xiesiqi1/git-test/README.md

# STM32F103 五路循迹小车

面向 **2026 全国大学生电子设计竞赛 H 题《车载平衡滚球运动控制系统》** 的循迹底盘。
目标是在 H 题赛道上完成 **"从 A 点出发 → 跑满一整圈 → 自动停在 A 点"**，并预留声光提示与里程接口给后续的滚球控制部分。

赛道与指标（H 题）：

| 项目 | 数值 |
|---|---|
| 赛道构成 | 2 × 1.5 m 直线 + 2 × R 0.5 m 半圆（黑线宽 1.8 cm） |
| 一圈周长 | 6.142 m |
| 限时 | ≤ 20 s（平均 ≥ 0.31 m/s） |
| 停车偏差 | ≤ 2 cm |

当前实测：**一圈 25.5 s**，自动停车由**里程**判定（`LAP DONE`），压线判定作为并行入口保留。

功能一览：

- 五路红外循迹，开环 PWM + 比例 + **虚拟前视**（用 `LEAD_TICKS` 把探头"电气前移"，等效约 3.9 cm）
- 弯道按差速**成比例收油**，并带**独立上限**（避免收油被积分项叠加到地板）
- **自动停车双入口**：压停止线 / 里程跑满一圈，二者共用同一个断油函数
- 1.3" OLED 实时显示误差、差速、左右 PWM、探头状态、编码器里程（本工程无串口，屏是唯一调试窗口）
- 跑圈计时（本圈 / 上圈）、A/B 点声光提示、掉速档案（`BMIN` / `LMAX` / `SLOW@`）
- 传感器极性 / 转向极性可在**不重新编译**的情况下用按键标定，结果存 Flash

---

## 一、硬件清单

| 部件 | 型号 / 规格 | 数量 | 与本工程的连接 |
|---|---|---|---|
| 主控 MCU | **STM32F103C8T6**（LQFP48，Cortex-M3，72 MHz，64 KB Flash / 20 KB RAM） | 1 | HSE 8 MHz 晶振 × PLL9 = 72 MHz |
| 电机驱动 | **L298N** 双 H 桥模块（VMS 7~12 V，ENA/ENB 接 1 kHz PWM） | 1 | 见下方引脚表 |
| 驱动电机 | 双直流减速电机，尾部带 **AB 相增量编码器** ⚠ 具体型号 / 减速比 / 轮径未记录 | 2 | TIM2（左）、TIM4（右）编码器接口 |
| 循迹传感器 | **5 路红外反射式数字量模块**（TCRT5000 类，带比较器与灵敏度电位器） ⚠ 具体型号未记录 | 1 | PA3 ~ PA7，MCU 内部上拉 |
| 显示屏 | **1.3 英寸 OLED，128×64，SH1106 驱动，SPI 4 线**（⚠ 不是 SSD1306：1.2 寸及以下才是） | 1 | SPI2 + 3 根控制线 |
| 蜂鸣器 | 3 脚**有源**蜂鸣器模块（VCC / GND / IO），**高电平响**（已实测） | 1 | PB0 |
| 指示灯 | 板载 LED，**低电平亮** | 1 | PC13 |
| 按键 | 轻触按键（内部上拉，按下接地） | 1 | PA15 |
| 下载器 | ST-Link V2（**SWD**，PA13 = SWDIO / PA14 = SWCLK） | 1 | — |
| 电源 | L298N VMS 接 7~12 V；逻辑侧由 USB / ST-Link 3.3 V 供电。**两侧必须共地** | — | — |

> ⚠ 标记项是本工程没有留下实测记录的参数。它们**不影响使用**：里程已按"一圈的实测脉冲数"标定，与轮径、编码器分辨率、减速比全部解耦。
> 若要补齐，只需在更换轮子 / 电机 / 编码器时重跑一次标定（见第四节第 6 步）。

机械安装要点：

- 五路探头前沿距车轴 **≥ 3 cm**（< 2 cm 必丢线），探头离地 **8 ~ 15 mm**。
- 轮距 **0.27 m**（实测值，已用于仿真模型）。

### 引脚分配

| 功能 | 引脚 | 说明 |
|---|---|---|
| 右电机 IN1 / IN2 | PA11 / PA12 | 方向 |
| 左电机 IN3 / IN4 | PA9 / PB3 | 方向（PB3 由 `SWJ_NOJTAG` 从 JTDO 释放） |
| 右 / 左 PWM | PB4 / PB5 | TIM3_CH1 / CH2，1 kHz |
| 左编码器 A / B | PA0 / PA1 | TIM2 编码器模式（TI1，单边沿计数） |
| 右编码器 A / B | PB6 / PB7 | TIM4 编码器模式（TI1） |
| 五路循迹 | PA3 ~ PA7 | 从左到右，输入上拉 |
| 按键 | PA15 | 单击 / 双击 / 三击 / 长按 |
| 蜂鸣器 | PB0 | 高电平响 |
| 板载 LED | PC13 | 低电平亮 |
| OLED | PB13 SCK / PB15 MOSI / PB12 CS / PB14 DC / PA8 RES | SPI2 只发主模式 |
| 下载 / 调试 | PA13 / PA14 | **SWD，不能用 JTAG** |
| 晶振 | PD0 / PD1 | ★ HSE 8 MHz，**绝不能当 GPIO** |

## 二、软件环境

| 项目 | 版本 | 说明 |
|---|---|---|
| Keil MDK-ARM | **V5.43**（UV4 5.43.1.0） | 打开 `MDK-ARM/Test1.uvprojx` |
| 编译器 | **ARMCC V5.06 update 20（AC5）** | 工程 `uAC6 = 0`，不是 AC6/Clang |
| 器件包 | **Keil.STM32F1xx_DFP 1.1.0** | Device = STM32F103C8 |
| STM32CubeMX | **6.15.0** | 工程文件 `TEST1.ioc` |
| STM32Cube 固件包 | **STM32Cube FW_F1 V1.8.7** | HAL 库 |
| 图形库 | u8g2（裁剪版） | `Middlewares/u8g2/`，仅 SH1106 + 6x10 / 5x7 字库 |
| Python 3（可选） | 3.x，**仅标准库**（math / random） | `tools/` 下的赛道仿真脚本 |

当前占用：**Flash 17.2 KB / 64 KB，RAM 2.7 KB / 20 KB**。

目录结构：

```
TEST1/
├─ Core/            CubeMX 生成的 HAL 初始化与 main.c（CtrlLoop 在 SysTick 中断里，5 ms 一拍）
├─ safe/            手写应用层：track / motor / encoder / key / oled / mileage / stopwatch / signal
├─ Middlewares/     u8g2 图形库
├─ MDK-ARM/         Keil 工程（Test1.uvprojx）
├─ tools/           赛道仿真：sim_H_track.py（主模型）/ sim_corner_slow.py / sim_turn_unify.py
├─ TEST1.ioc        CubeMX 工程
└─ car.txt          ★ 接线表 + 调参手册（19 节，故障排查全部在这里）
```

## 三、快速启动

### 0) 获取代码

```bash
git clone git@github.com:xiesiqi1/git-test.git
cd git-test
```

仓库地址：<https://github.com/xiesiqi1/git-test>

> 仓库里**不含编译产物**（`MDK-ARM/Test1/` 整个输出目录已在 `.gitignore` 中忽略），
> `Test1.hex` 需要按下一步自行编译生成。这样每次提交只反映真实的代码改动，
> 不会混入几十个 `.o` / `.axf`。

### 1) 接线

按 `car.txt` 第一 ~ 五节接线。**最容易漏的一条：L298N 的 GND 必须与 STM32 的 GND 相连**，否则电机乱转或不动。

### 2) 编译

Keil 图形界面：打开 `MDK-ARM/Test1.uvprojx` → `Rebuild`（全量）→ 必须 **0 Error / 0 Warning**。

命令行（等价，便于脚本化）：

```bash
cd MDK-ARM
"C:/Keil_v5/UV4/UV4.exe" -r Test1.uvprojx -j0 -o build_log.txt
```

> `-r` 全量重建，`-b` 增量编译。**"0 Error / 0 Warning"是硬规矩**：本项目曾因注释少一个 `*/` 把下一行宏定义吞掉，编译器只给一条警告、不报错。

### 3) 下载

ST-Link + SWD 下载。`Options for Target → Debug → Settings → Flash Download` 里擦除方式选 **Erase Sectors**：

> ⚠ **不要用 Erase Full Chip**。传感器极性 / 转向极性标定值存在 Flash 尾部，全片擦除会退回默认值 —— 那会让车"突然朝赛道对角直冲"。

### 4) 上电自检

上电后 OLED 应显示自检画面，**蜂鸣器应安静**（一直响说明电平方向反了，改 `BUZZER_ACTIVE_LEVEL`）。
把两个轮子**架空**，长按 PA15 超过 0.8 s：左轮前进 1 s → 停 → 右轮前进 1 s → 停。用来确认电机接线、左右是否搞反。

### 5) 跑一圈

在起步位置的车轮下做个记号 → 短按 PA15 启动 → 车自动循迹一整圈 → 里程到 6.142 m 时**立即断油停车**，屏上第 1 行显示：

```
LAP DONE  T 25.5      ← 里程判定停车（T = 本圈成绩）
HIT LINE  T 25.5      ← 压停止线判定停车
```

两个标签就是"是哪个入口停的"的唯一线索。

### 6) 对准停车点（目标 ≤ 2 cm）

量车轮标记相对起步标记差了几厘米：

- 冲过头 → `STOP_MILEAGE_COUNT` **调小**
- 没到 → **调大**

标尺：**1 cm ≈ 2300 计数**（一圈 6.142 m = 1 400 000 计数）。
只改这一个数，**不要动 `MILEAGE_LAP_COUNT`** —— 它还管着 B 点提示的位置。

## 四、关键参数（`safe/config.h`）

| 宏 | 当前值 | 含义 |
|---|---|---|
| `CTRL_PERIOD_MS` | 5 | 控制周期（SysTick 中断） |
| `SIMPLE_BASE_SPEED` | 32 | 直道基础 PWM（提速只调这一个，一次 +4） |
| `SIMPLE_KP` | 14 | 比例增益 |
| `SIMPLE_LEAD_TICKS` | 30 | 虚拟前视拍数（等效探头前移 ≈ 3.9 cm） |
| `SIMPLE_CORNER_SLOW` | 50 | 弯道按差速成比例收油（%） |
| `SIMPLE_CORNER_SLOW_MAX` | 6 | ★ 收油**绝对上限**（不动差速，只压收油） |
| `SIMPLE_LOST_SPEED` | 20 | 丢线时的降速值 |
| `MILEAGE_LAP_COUNT` | 1400000 | 一圈的编码器平均计数（已标定） |
| `STOP_MILEAGE_ENABLE` / `STOP_MILEAGE_COUNT` | 1 / 1400000 | 里程停车入口 |
| `STOP_LINE_ENABLE` / `ARM_COUNT` | 1 / 1120000 | 压线停车入口 + 里程门槛（80%） |
| `STOP_LINE_MIN_ACTIVE` / `CONFIRM` | 4 / 6 | 连续 4 路 + 连续 6 拍 |
| `BUZZER_ACTIVE_LEVEL` / `LED_ACTIVE_LEVEL` | 1 / 0 | 蜂鸣器高电平响、LED 低电平亮（方向相反） |

调参方法与故障排查表见 `car.txt`：第十五节（OLED）、第十六节（自动停车）、第十七节（声光与里程）、第十八节（实车读数范例）、第十九节（掉速定因）。

## 五、屏幕读数

运行时（6 行 × 21 字符）：

```
RUN  T12.3 L11.8     本圈 / 上圈计时
E  -2    LOST 0      夹线误差(-4~+4, 99=丢线) / 连续丢线拍数
B  32    DIFF -12    本拍基础速度(含收油) / 本拍下发的差速
L  44    R  20       左右轮 PWM
[ ][X][X][ ][ ]      五路探头，实心 = 压到黑线
ENC 1582 1204 M2     左右累计计数(÷1000) + 已到哪个标记点
```

停车后第 2、3、4 行换内容（`B/DIFF/L/R` 停车后没有信息量）：

```
BMIN 26/26 LMAX 0    本圈最小 base（看见线 / 含丢线拍）+ 最长连续丢线拍数
EVT  4  MAXW 5       宽线事件次数 / 整圈最宽一拍压了几路
SLOW@ 141K WIDE@ 850K  最慢那一拍的位置 / 首次触发的位置（单位：千计数）
```

## 六、注意事项

1. **CubeMX 重新生成代码会覆盖 `Core/*`、清掉 `Middlewares/u8g2/`、并可能把 HSE 改回 `RCC_HSE_OFF`**（那样上电没反应）。每次 Generate 后必须检查 `.ioc` 里 PD0/PD1 仍是 OSC_IN/OSC_OUT，以及 `SystemClock_Config()` 里的 `HSEState`。
2. `CtrlLoop()` 跑在 **SysTick 中断**里，任何地方都不能死等（声光提示用状态机 + 自动重装，不用 `HAL_Delay`）。
3. 跑动中**不要抬车、不要用手挡探头**：五路全黑会被判成"压到宽线"，门槛满足时会当场停车。
4. 本工程**没有串口**（PA9/PA2/PA3 已被电机与探头占用），唯一调试窗口是 OLED。

## 七、当前状态与待办

- ✅ 循迹、计时、OLED、双入口自动停车、声光、里程标定、掉速档案
- ✅ 一圈 **25.5 s**（仿真 25.21 s，误差 1%）
- ⏳ 提速到 ≤ 20 s：`SIMPLE_BASE_SPEED` 32 → 36 → 40，每档回看 `BMIN`（掉到 19 = 收不够）与 `LMAX`（> 10 = 开始丢线）
- ⏳ `EVT` 改为边沿计数（现在一次穿越会记 4~7 次）
- ⏳ 补齐电机 / 编码器 / 轮径的型号记录
- ⏳ H 题第 4 / 6 项：钢球稳定在摆杆中心（尚未开始）
