xiesiqi1/git-test/safe/config.h

#ifndef __CONFIG_H
#define __CONFIG_H

/* ============================================================
 *                    循 迹 参 数 总 表
 * ============================================================
 * 赛道(2026 电赛 H 题): 2 段 1.5 m 直线 + 2 个半径 0.5 m 半圆,
 *   黑线宽 1.8 cm, 周长 = 2×1.5 + 2×π×0.5 ≈ 6.14 m
 *   要求一圈 <= 20 s  ->  平均速度必须 >= 0.31 m/s
 *   标定基准: 直线段 1.5 m 要在 4.8 s 内跑完(用秒表量)
 *
 * ★★★ 最重要的一条: 探头【必须装在驱动轮轴的前方】★★★★
 *   2026-09-25 仿真结论(已含偏航静摩擦, 用本文件当前参数重扫): 探头相对
 *   驱动轮轴的前后位置是悬崖式的临界 ——
 *        探头在轮轴后 1 cm  -> 出线(偏离 6.0 cm)
 *        探头正好在轮轴上  -> 出线(偏离 6.1 cm)
 *        探头前移 0.5 cm   -> 出线(偏离 6.0 cm)
 *        探头前移 1.0 cm   -> 会丢线(横偏 49 mm, 丢线 899 拍)
 *        探头前移 2.0 cm   -> 能跑(横偏 15.8 mm, 余量很小)
 *        探头前移 3.0 cm   -> 好(横偏 8.2 mm)
 *   为什么: 只有"提前看到"才能提前打舵。探头在轮轴上时, 等它发现偏了, 车
 *   已经冲出去了 —— 表现就是"进弯反应慢, 等跑出弯道才转弯, 然后找不到线"。
 *   ★ 实测方法: 量一下【两驱动轮中心连线】到【探头板中心】的前后距离。
 *     小于 2 cm 就别调参数了, 先把它往前挪到 3~4 cm, 比改任何参数都管用。
 *   (注: 补上偏航静摩擦后, 这个悬崖从 1 cm 往后挪到了 2~3 cm —— 车更难转,
 *    对前视的要求就更高。)
 *
 * ★★★ 第二条关键原理: 车要克服"偏航静摩擦"才转得动 —— 所以打舵量必须够大
 *   纯运动学算出来的"过弯需要的差速"小得离谱:
 *       需要的差速(PWM) = (基础速度 − 电机死区) × 轮距 ÷ (2 × 圆弧半径)
 *       (死区取 8; 除以 2 是因为差速是"一侧加一侧减")
 *   H 题(轮距 0.15 m, R=0.5 m): base 32 只要 3.6 PWM。
 *   ⚠ 但这个数【只是下限, 不能用来判断"力度够不够"】: 它算的是"忽略一切
 *     摩擦时, 轮速差要多大"。真车还要先把前支撑/斜撑被横向拖动的静摩擦
 *     推开, 车才开始转 —— 仿真里把这个门槛设成 12 PWM 时, 车的行为就和
 *     实车反馈的"车头转一点、车身往外滑、整条弯贴着探头边缘"完全一致。
 *   结论: 打舵量按【静摩擦门槛】定, 不要按几何公式定。调法见 SIMPLE_KP 与
 *     下面 SIMPLE_TRIM_KI 的注释; 公式只用来估计换赛道后的相对变化。
 *
 * 【怎么调, 按顺序来】
 *   0. ★ 先确认探头的物理前视距离(见上) >= 2 cm(最好 3~4 cm)。不到就先挪探头。
 *   1. 再把 SIMPLE_BASE_SPEED 定在"能稳定沿线跑完整圈"为止。
 *      它是唯一真正决定快慢的旋钮 —— 别用 Kp 去换速度。
 *   2. 进弯迟钝 / 弯道冲出去 -> 加大 SIMPLE_LEAD_TICKS(30->40)。
 *   3. 两个弯"打舵量不一样"(如 内0外60 vs 内15外40) ->
 *      ★ 先看是不是"某个弯车偏出去了"(探头压到最外 1~2 路)。是的话就是
 *      【进弯打舵太晚】, 加大 SIMPLE_LEAD_TICKS —— 不要靠砍
 *      SIMPLE_DIFF_MAX 去"强行统一", 那会把纠偏能力一起砍掉(见上面这条的
 *      实车依据)。只有"两个弯误差都在 ±1 但差速差很多"才去查前视/限幅。
 *   4. 弯道能进、也减速了, 但转不过去(车头转、车身往外滑) ->
 *      这是【打舵量不够克服偏航静摩擦】: 加大 SIMPLE_KP(14->18->24),
 *      或加大 SIMPLE_TRIM_KI(150->220)。
 *   5. 直线压不住/持续画龙 -> 调小 SIMPLE_KP; 直道细碎抖动 -> 调小
 *      SIMPLE_LEAD_TICKS 或加大 SIMPLE_LEAD_TAU。
 *   一次只改一个参数、一次改 20~30%, 改完就试。
 * ============================================================ */

/* ---------------- A 组: 速度与打舵力度 ---------------- */
#define SIMPLE_BASE_SPEED   32    /* 基础前进速度 0~100(PWM 百分比)。
                                   * ★ 当前 32: 从 24 提上来的那一档。循迹在
                                   *   这一档稳住了再往 42 加, 每次 +4。
                                   * 仿真(含偏航静摩擦 12 PWM, 用本文件的
                                   *   Kp=14 / 上限32 / Ki=150 重扫):
                                   *     24 -> 39.4 s   弯中偏离 1.3 格
                                   *     28 -> 33.7 s   弯中偏离 1.2 格
                                   *     32 -> 25.8 s   弯中偏离 1.1 格  ★ 当前
                                   *     36 -> 22.4 s   弯中偏离 1.1 格
                                   *     42 -> 18.0 s   弯中偏离 1.2 格  <- 进 20 s
                                   *   ⚠ 这一版速度阶梯【比上一版显著变慢】:
                                   *     因为模型里补上了偏航静摩擦 —— 车要花
                                   *     力气克服它。上一版 22s/19s 那张表是在
                                   *     "没有任何偏航阻力"的模型里算的, 不可信。
                                   * 架空能转、下地不动 -> 每次 +4;
                                   * 一下地就窜/发飘     -> 每次 -4。 */
#define SIMPLE_KP           14    /* 比例: 【预测误差】每偏离【一整格】给多少 PWM。
                                   * 注意它乘的是下面"虚拟前视"算出来的预测
                                   * 误差, 不是原始误差。
                                   * ★★ 2026-09-25 从 8 回到 14, 原因是本文件
                                   *   开头那条【偏航静摩擦】:
                                   *   车要克服前支撑被横向拖动的静摩擦才转得动,
                                   *   所以"打舵量"必须够大才有任何效果。8 这一档
                                   *   在弯里只给出 4 PWM 的差速, 全被静摩擦吃掉
                                   *   —— 表现就是"车头转一点、车身照样往外走,
                                   *   整条弯都贴着探头边缘跑"。
                                   * 偏了回不来 / 过弯冲出去 -> 加大(14->18->24);
                                   * 直道来回摆               -> 调小(14->12->10)。
                                   * ★ 进弯迟钝【不要】靠加大它来治 —— 那一定
                                   *   同时把直线搞毛躁。交给虚拟前视和曲率积分。 */
#define SIMPLE_LEAD_TICKS   30    /* ★★ 虚拟前视(单位: 控制拍)。它取代了旧版的
                                   *   SIMPLE_KD 微分项, 是"进弯反应慢"的正解。
                                   *
                                   * 干什么: 传感器只看得见车正下方。这里把"误差
                                   *   正在变化的速度"低通之后往外推 N 拍, 相当于
                                   *   把探头【虚拟地往前挪】。探头装得越靠后,
                                   *   这个值就越该加大。
                                   * 等效前视距离 ≈ 拍数 × 0.005 s × 车速:
                                   *   本车 0.26 m/s 时  20 拍 ≈ 2.6 cm
                                   *                     30 拍 ≈ 3.9 cm
                                   *
                                   * ★★ 2026-09-29: 20 -> 30。实车依据是两个弯
                                   *   "打舵量不统一" ——
                                   *     弯1 内轮0 / 外轮60   (差速约 30, 顶到上限)
                                   *     弯2 内轮15 / 外轮40  (差速约 12.5)
                                   *   用输出方程反推(纯代数, 不依赖任何模型):
                                   *     `内轮 = 基础速度 - 差速`, 而基础速度又随
                                   *     差速自动收油 50%, 所以 `内轮 = 32-1.5x差速`;
                                   *     差速到 21.3 时内轮算成负数, 被"平移夹"抬到
                                   *     0, 同时外轮被推成 `2x差速` = 60。反推得
                                   *     弯1 的差速确实到了 30。
                                   *   差速要 30, 只有误差打到最外侧(±4)才凑得出
                                   *   —— 也就是【车在第一个弯先偏出去了, 控制器才
                                   *   拼命补】。仿真(含偏航静摩擦, 探头前视 3cm)
                                   *   反复验证: 上限砍到 13 能让两个弯"看起来
                                   *   统一", 代价是弯里误差从 1.0 涨到 4.0、最大
                                   *   横偏 8.5 -> 40.8 mm(探头半跨只有 20 mm, 超了
                                   *   就丢线), 摩擦假设偏大时直接出线。所以正解
                                   *   不是砍舵, 而是让车【别偏出去】。
                                   *   仿真(本文件当前参数, 只改这一项 20->30):
                                   *     最大横偏 8.5 -> 2.4 mm, 两个弯的误差都稳在
                                   *     1.0, 打舵饱和率降到 0%, 圈时 25.9 -> 26.1 s
                                   *   —— 差速不是被砍小的, 是"车不偏出去所以两个
                                   *   弯自己落到同一档"。
                                   *
                                   * ★ 为什么不能直接用 KD: 旧代码的 KD 是"本拍误差
                                   *   − 上一拍误差", 而数字探头是【一格格跳】的,
                                   *   这个差值只在那一拍(5ms)出现一次, 而电机+
                                   *   齿轮箱的机械时间常数约 30~50 ms —— 5ms 的
                                   *   指令还没等轮子转起来就没了, 等于白给。
                                   *   仿真已验证: 把 KD 从 8 加到 16、24, 在
                                   *   "探头前视不足"的场景下【一次都没救回来】;
                                   *   换成这里的低通外推立刻见效。
                                   *   低通(见 LEAD_TAU)的作用就是把这个尖峰摊成
                                   *   持续约 100 ms 的指令, 电机才跟得上。
                                   *
                                   * 还嫌进弯慢 -> 加大(30->36->40), 上限 40 ——
                                   *   仿真里 40 在传感器误判率高时会失稳出线。
                                   * 直道细碎抖动 -> 调小(30->20->12), 那是把
                                   *   传感器噪声也一起外推出去了。 */
#define SIMPLE_LEAD_TAU     20    /* 上面那个"误差变化速度"的低通时间常数(单位:
                                   * 拍)。20 拍 = 100 ms, 和电机的机械时间常数
                                   * 同量级 —— 正好把瞬时跳变摊成电机跟得上的
                                   * 持续时间。
                                   * 抖动大 -> 加大(20->30->40), 但外推会更钝、
                                   * 进弯会慢一点; 反应还不够快 -> 调小。 */
#define SIMPLE_D_LIMIT      3     /* 每拍误差跳变的限幅(单位 半格/拍)。
                                   * 数字探头遇到"黑线从最左一路跳到最右"这种
                                   * 野值时, 差分能达到 8; 不限幅会被外推成猛舵。
                                   * ★ 3 是给虚拟前视让路的: 限幅卡在 3 时, 20 拍
                                   *   外推最多给出 20×3 = 60 个半格的预测偏差,
                                   *   够用了; 卡得更小(2)就等于把前视力度砍一半。 */

#define SIMPLE_TRIM_KI      150   /* 积分速度: 千分之一 PWM / (拍 × 半格)。
                                   * 150 = 误差偏一格时每拍涨 0.15 PWM ——
                                   * 大约 0.5 秒涨够 15 PWM 的偏置。
                                   * 弯中还是贴边(余量不够)   -> 加大(150->220);
                                   * 直道开始缓慢地来回摆     -> 调小(150->100)。 */
#define SIMPLE_TRIM_LIMIT   16    /* 积分偏置的上限(PWM)。必须有上限, 否则
                                   * 万一长时间偏在一侧会积到很大、出弯后
                                   * 收不回来(积分饱和/风偏)。
                                   * 仿真: 16 最好; 给到 36 反而破坏直道。 */
#define SIMPLE_TRIM_TAU     50    /* 误差回到线上(±1 以内)之后, 积分按这个
                                   * 时间常数泄漏掉(单位: 拍, 50 拍 = 250ms)。
                                   * 它决定"出弯后多快把弯道的偏置退干净"。
                                   * ★ 仿真里 45~60 是一段稳健平台, 取中间的 50。
                                   * 出弯后车往一边偏一下 -> 调小(50->30), 退快点;
                                   * 弯中偏置总是不够     -> 调大(50->70), 留久点。 */

/* ---------------- B 组: 弯道姿态 / 丢线 ---------------- */
#define SIMPLE_DEAD_BAND    0     /* 死区(单位 半格)。★ 当前 0 = 不设死区,
                                   * 偏半格就开始修 —— 这是"别等偏出去才纠正"
                                   * 的关键。
                                   * 代价: 宽线骑在两路之间时误差会在 ±1 之间
                                   * 来回, 差速跟着抖几 PWM; 但控制周期只有
                                   * 5ms(200Hz), 电机机械上根本跟不上, 实际
                                   * 被平掉了, 肉眼看不出来。
                                   * 若真在直道上看到左右抖动 -> 改回 1。 */
#define SIMPLE_DIFF_MAX     32    /* 差速上限(单侧最大修正量, PWM)。
                                   * 这是"差速夹"—— 防止某一拍野值把舵打成猛舵。
                                   * ★ 24 -> 32: 比例项提到 14 之后, 弯里
                                   *   (预测误差 4 格) 本身就要 28 PWM, 再加
                                   *   曲率积分的偏置, 24 会把它夹住 —— 那等于
                                   *   又变回"最需要打舵的时候打不出去"。
                                   * 直道误差只有 ±1 格, 算出来最多 7 PWM, 根本
                                   * 碰不到这个上限 —— 所以放宽它不会让直道变猛,
                                   * 只放大"已经快跑丢"那一档的最大打舵量。 */
#define SIMPLE_DIFF_SLEW    3     /* ★ 差速【变化率】上限, 单位 PWM/控制拍。
                                   * 0 = 关闭(旧行为, 差速一拍就能跳到位)。
                                   *
                                   * 【为什么需要它 —— 2026-09-25 实车反馈】
                                   *   "力度是够的, 是每次左右调速时左右差速过大,
                                   *    偏离赛道了。"
                                   *   这句话点出的不是"最大舵量", 而是"舵量的
                                   *   变化速度": 误差从 +2 跳到 -2 时, 差速会从
                                   *   +14 变到 -14 —— 一拍(5ms)之内跳 28 PWM。
                                   *   电机机械时间常数 30~50ms 根本跟不上, 于是
                                   *   车得到的是一个"阶跃"指令: 先猛地一拧、车头
                                   *   甩过去, 等传感器看回来时已经转过头了, 再
                                   *   反向猛拧 —— 就这样一顿一顿地被甩出赛道。
                                   *
                                   *   加上它之后, 差速只能"爬"上去而不能"跳"上去
                                   *   (3 PWM/拍 → 从 0 到满舵约 55ms, 和电机时间
                                   *   常数同量级)。★ 关键是它【不降低任何上限】:
                                   *   持续偏一侧时照样能到达满舵, 所以不会削弱
                                   *   "克服静摩擦的力气"。
                                   *
                                   * 取值: 3 是仿真扫出来的平台(1 太慢会跑丢,
                                   *   2~6 都可用, 3 在不同摩擦假设下都不会变差)。
                                   *   还觉得"一顿一顿" -> 调小(3->2);
                                   *   进弯反应变钝了   -> 调大(3->5->8, 或 0 关闭)。 */
#define SIMPLE_CORNER_SLOW  50    /* 弯道自动收油 %: 打舵越狠, 基础速度降得越多。
                                   * ★★ 15 -> 50。15 在 base=24 时几乎等于没减速
                                   *   (|diff| 最大 16 → 只降 2.4 PWM), 提速后
                                   *   "看到弯却收不油", 等于这个保险【形同虚设】。
                                   *   50 才真正生效: 最外侧压线那一拍 base 32
                                   *   → 32-10 = 22, 差速 20 → 内侧轮只剩 2 PWM,
                                   *   效果是"边收油边大角度转"。
                                   * ★ 2026-09-25 加虚拟前视后, 这条的"结构缺陷"
                                   *   顺手被补上了: 以前收油量只看 |当前打舵|,
                                   *   进弯第一拍打舵还小、收得最少, 最需要减速的
                                   *   那一刻反而收得少; 现在打舵量里含有前视项,
                                   *   误差一开始变化就打舵, 收油也就跟着提前了。
                                   * 换小半径紧道靠它加大(50~70)。
                                   *
                                   * ★★ 2026-09-29: 单靠它【会收过头】——
                                   *   实测反馈"车跑到后面的转弯时明显减速"。
                                   *   原因: 收油量 = |diff| x 50%, 而弯道里
                                   *   diff 里含着【曲率积分】, 它在弯里顶到
                                   *   上限且不泄漏, 于是收油被叠到最大:
                                   *       直道 base 32 -> 弯道 24 -> 最深 19
                                   *   （正好撞上 CORNER_MIN 地板 19.2）。
                                   *   现在由下面的 SIMPLE_CORNER_SLOW_MAX
                                   *   兜底封顶, 本值保持 50 不用改。
                                   * 想让弯道再快一点 -> 降到 35（仿真: 圈时
                                   *   再快 0.2s, 但弯道横偏 5.2->6.6 mm, 噪声
                                   *   下 13.8->16.5 mm, 越靠近探头半跨 20 mm
                                   *   越危险, 别一次降太多）。 */
#define SIMPLE_CORNER_SLOW_MAX 6  /* ★★ 弯道收油的【绝对上限】(PWM)。
                                   * 2026-09-29 新增, 治"跑到后面的弯明显
                                   *   减速"。
                                   *
                                   * 干什么: 上面那条是"按打舵量成比例收油",
                                   *   本值给收油量封个顶 —— 不管 diff 飙到
                                   *   多少, 弯里最多只降这么多 PWM。
                                   *
                                   * 为什么必须有: |diff| 在弯里含曲率积分,
                                   *   而积分在持续弯道【顶到上限且不泄漏】,
                                   *   于是收油被叠加到最深。仿真(轮距 0.27 m):
                                   *       现状(无上限)  弯 base 24, 最深 19, 27.38 s
                                   *       加上限 6      弯 base 26, 最深 26, 25.21 s
                                   *   即"最慢的那一瞬间"从 19 提到 26 (+37%),
                                   *   圈时快 2.2 s, 而且弯道横偏反而从 8.6 mm
                                   *   降到 5.2 mm（不再被夹到地板）。
                                   *
                                   * 取值: 6 → 弯里 base 26(直道 32 的 81%)。
                                   *   · 还嫌弯里慢      -> 加大(6->8->10);
                                   *   · 弯道有偏出去/丢线 -> 调小(6->4), 或
                                   *     把上面的 CORNER_SLOW 降一档。
                                   * ⚠ 别设成 0：0 = 关闭收油, 弯道会全速冲。 */
#define SIMPLE_CORNER_MIN   60    /* 收油下限(占基础速度 %), 别降到电机带不动。
                                   * ★ 75 -> 60: 75% 对 base 32 来说是"地板 24",
                                   *   等于把收油卡死（最多只能降到 24）;
                                   *   60% → 地板 19.2, 才留出真正的下探空间。 */
#define SIMPLE_LOST_TURN    1     /* 丢线时: 1=朝最后偏离的方向满舵回找;
                                   * 0=保持直行。 */
#define SIMPLE_LOST_SPEED   20    /* ★ 知道往哪边找时的速度(PWM)。
                                   * 以前这里用的是基础速度(32) —— 一圈丢线补偿
                                   * 时"满舵 + 全速"= 轮胎打滑空转, 车照样直着
                                   * 滑出去, 这就是"丢线以后怎么都找不回来"的
                                   * 原因。降到 20 让轮子抓得住地: 内侧轮被
                                   * 差速夹推到 0, 车变成【原地小半径拐】,
                                   * 而不是高速侧滑。
                                   * 还是找不回来 -> 再降(20->16); 太慢挪不动 -> 加。 */
#define SIMPLE_LOST_BOOST_CNT 3   /* 连续丢线几拍之后开始额外加力(3拍=15ms)。 */
#define SIMPLE_LOST_BOOST   10    /* 额外加力的量(PWM)。"丢线"算出来的舵量和
                                   * "最外侧探头压线"是同一个值, 等于没加重,
                                   * 所以必须在这里再补一把。 */
#define SIMPLE_LOST_SLOW_TICKS 8  /* ★★ 2026-09-29 新增: 连续丢线要【达到这么多拍】,
                                   *   才把当时的速度算进屏上那条"掉速档案"。
                                   *
                                   * 为什么必须有: LOST_SPEED 是"一丢线立刻降速",
                                   *   而 3~5 拍(15~25ms)的瞬断在物理上什么都改变
                                   *   不了 —— 电机机械时间常数 30~50ms, 15ms 的
                                   *   降速指令还没等轮子响应就结束了。
                                   *   但它会被记成"本圈 base 最小值", 屏上于是
                                   *   显示 `BMIN 26/20 LMAX 3` —— 看起来像真出了
                                   *   故障, 实际上只是一次 15ms 的瞬断。
                                   *   (2026-09-29 实测第一次就踩到这个坑。)
                                   *
                                   * 8 拍 = 40 ms, 与电机时间常数同量级: 比它短的
                                   *   丢线【物理上不可能】造成可见减速, 不该进档案。
                                   * ⚠ `LMAX` 那一项仍然记【原始最大值】(不去抖),
                                   *   所以"这一圈到底有没有瞬断"照样看得见。 */

/* ------------- C 组: 起步保护(防"一启动就窜出去") ------------- */
#define SIMPLE_SEARCH_SPEED 12    /* ★ 从没找到过黑线时允许的最大速度。
                                   * 旧版本这里用的是 BASE_SPEED —— 只要启动
                                   * 瞬间探头没压到线, 车就会【全速直线冲出去】,
                                   * 而且越走离线越远, 永远回不来。
                                   * 现在改成慢爬, 顶多原地慢慢挪。 */
#define SIMPLE_RAMP_MS      300   /* ★ 软启动: 启动后输出在这段时间内从 0 线性
                                   * 升到目标值, 消除"一按启动就窜出去/轮子
                                   * 打滑"。嫌起步慢就调小(300->150),
                                   * 0 = 关闭软启动。 */

/* ============================================================
 *            传 感 器 极 性 (黑线对应哪种电平)
 *   0 = 压到黑线时, 模块输出【低电平】
 *   1 = 压到黑线时, 模块输出【高电平】
 *
 * ★ 这里只是【出厂默认值】。运行中可切: 停止状态下【双击 PA15】,
 *   切换后会立刻写进 Flash 保存, 断电/复位/重新烧录都不会丢。
 *   判据: 短按启动后, 车是"追黑线"还是"躲黑线"。
 *   极性反了的典型现象 —— 车几乎不理会黑线, 一路直着往前冲:
 *   探头看到"白"被当成看到"黑", 5 路一起算出来的误差恒为 0。
 *
 * ★★ 本车实车标定结果: 用 1。
 *    2026-09-25 实测记录: 把这里改成 0 之后, 车会【一直绕圈】(明显不对),
 *    改回 1 即恢复正常 —— 所以最终取 1。
 *    ⚠ 这类"黑线对应哪种电平"只能上车试: 模块指示灯和排针输出有的同相、
 *      有的反相, 靠"灯亮 / 灯灭"去推断不可靠 —— 本项目已因此来回改错两次。
 *    若哪天换了模块/重接了线又不对: 【双击 PA15】翻一次(会自动保存),
 *    试准之后再把这里改成对应的值。
 * ============================================================ */
#define TRACK_ACTIVE_LEVEL_DEFAULT  1

/* ============================================================
 *              转 向 极 性 (修正方向对不对)
 *   (+1) / (-1), 同样只是【出厂默认值】, 可用【三击 PA15】切换 + 保存。
 *
 * 含义:
 *   (+1) = 代码假定的"标准接线" —— 传感器"第1路"在车最左、左电机接左轮。
 *          此时 err>0(黑线在车右边) -> 左轮快/右轮慢 -> 车向右追线。
 *   (-1) = 上面任一处接反了, 用它把整套转向动作整体翻过来。
 *
 * 判据(30 秒, 不用上车跑): 把黑线放在【最左边】探头下, 短按启动,
 *   车应该【向左】转; 放最右边应该向右转。反了就是这个开关反了。
 * 成因只有两个, 而且现象一样(都等价于"看左当成看右"):
 *   (a) 五路模块排针的左右顺序接反;  (b) 左右电机接线对调。
 *
 * ★★ 本车实车标定结果: (-1)。
 *    2026-09-25 实测: 用 (+1) 时【左右修正方向是反的】—— 车往黑线的反方向
 *    拐; 改成 (-1) 即正确。
 *    ⚠ 这类方向问题【无法从代码里推导出来】(公式本身是自洽的), 只能上车试。
 *      本项目已经因为"凭症状推理"来回改错过好几次, 所以只认实测结果 ——
 *      判据就是上面那条: 黑线放最左探头下, 车应该向左转。
 *    若哪天换了车 / 重接了线又反了: 【三击 PA15】翻一次即可(会自动保存),
 *    试准之后再把这里改成对应的值。
 * ============================================================ */
#define TRACK_TURN_SIGN_DEFAULT     (-1)

/* ============================================================
 *                 OLED (1.3 寸 SH1106 128x64, SPI2)
 * 2026-09-28 新增。与循迹控制完全无关, 只是显示。
 * 引脚: SCK=PB13, MOSI=PB15, CS=PB12, DC=PB14, RES=PA8 (详见 car.txt)
 * ============================================================ */

/* 刷新周期(ms)。刷一屏 = 1024 字节, 4.5 MHz 下阻塞约 1.8 ms。
 *   100 ms = 10 Hz -> 占 CPU 不到 2%, 数字跳动也还算跟得上手。
 *   想更流畅可以调到 50(20 Hz, 约 3.6% CPU), 再快就没必要了 ——
 *   毕竟控制环只跑 5 ms 一拍, 屏上本来也看不清。
 * ⚠ 不要调到 5 以下: 那等于每拍都刷, 主循环(按键扫描)会被拖住。 */
#define OLED_REFRESH_MS     100u

/* --- 文字在屏幕上的垂直排布 (2026-09-29 新增) ---------------
 * 背景: 1.3 寸 SH1106 是 128x64, 共 64 行像素, 而模块的塑料窗口会
 *   盖住最上/最下各约 3~4 行 —— 实车观察"屏幕上下的字各缺小半行"。
 *   所以 6 行内容必须【整体内缩】, 不能从 y=0 排到 y=63。
 *
 * 6x10 字体一行实际占约 10 px, 6 行 = 60 px。想在 64 px 里上下
 * 各留出余量, 行距只能压到 9 px:  6 x 9 + 上下边距 = 62 px, 刚好。
 *   行 y 坐标 = OLED_Y0 + 行号 x OLED_ROW_H
 *
 * ★ 现场微调(不用改别的代码, 只动这两个数):
 *     · 整体偏上/偏下  -> 改 OLED_Y0   (默认 4; 越大越往下)
 *     · 字挤/被切      -> 改 OLED_ROW_H(默认 9; 加大到 10 更松,
 *                        但 6 行 x 10 = 60 px, 上下就只剩 2 px 余量)
 *     · 如果调到 8 还被切, 说明屏幕有效区比 64 行更小, 需要减行。
 */
#define OLED_Y0             4     /* 第 1 行的 y 坐标(像素) */
#define OLED_ROW_H          9     /* 相邻两行的 y 间隔(像素) */

/* ============================================================
 *                 停 止 线 检 测 (safe/track.c)
 * 2026-09-29 新增。需求: "检测到停止线就自动停止"。
 *
 * ★★ 2026-09-29 下午【重要修订】: 原来的"连续 3 路压黑 + 连续 2 拍"
 *    在实车上【误判严重】—— 车没跑完就被停住了。
 *
 * 为什么必然误判(这不是参数没调好, 是那个判据本身分不开):
 *      循迹黑线, 走直       -> 压 1~2 路
 *      循迹黑线, 车头一斜   -> 线的横向投影变宽 -> 压到 3 路   ★ 与停止线重叠
 *      停止线(5 cm 宽)      -> 压 3~4 路
 *   也就是说"3 路"既可能是停止线, 也可能是【弯道里斜着压普通线】。
 *   而 5 cm 宽的停止线本身最多也只能压到 3~4 路 —— 所以【只看"压了几路"
 *   这一个维度, 门槛设几都分不开】。想靠宽度彻底分开, 停止线得加宽到 >=8 cm。
 *
 * ---- 现在改成【三个维度同时成立】才判定 ----
 *   ① 里程门槛 STOP_LINE_ARM_COUNT: 车必须【已经跑够这么多编码器计数】
 *      才允许触发。这是最关键的一条 —— 误判都发生在中途, 而停止线只在
 *      终点前出现, 一条门槛就把前面所有干扰全挡掉。
 *   ② 宽度 STOP_LINE_MIN_ACTIVE: 连续几路同时压黑(3 -> 4, 加严一档)。
 *   ③ 确认 STOP_LINE_CONFIRM: 连续几拍都成立(2 -> 6 拍 = 30 ms,
 *      车速 0.26 m/s 约等于 8 mm) —— 滤掉单拍毛刺。
 *
 * ---- 启动保护(STOP_LINE_ARM_TICKS) ——
 * 启动后这么多拍之内【不检测】, 防止起点那根启停线一按启动就把车停住。
 * 200 拍 x 5 ms = 1.0 s, 车速 0.26 m/s 约等于 26 cm。
 * ⚠ 车是【停在启停线上】起步的(H 题 A 点), 所以这个保护必须有。
 *   若你的起跑线在车前方 30 cm 以内, 把这个值加大到 400。
 *
 * ★★ 启用状态(2026-09-29 20:30) —— 三步已全部完成:
 *    第 1 步 ✅ 观测模式跑了好几圈, 拿到三个关键数字:
 *              一圈计数 ≈1.40M、压线时【最宽 5 路】、
 *              【那条宽黑线的位置 = 一圈的 61%】(三次 862K / 867K / 850K)。
 *    第 2 步 ✅ MILEAGE_LAP_COUNT = 1400000 已填(见下面"里程"段)。
 *    第 3 步 ✅ STOP_LINE_ENABLE = 1, ARM_COUNT 按下面的表取。
 *
 * ★★★ 里程门槛 ARM_COUNT 怎么填 —— 唯一依据是【实测那条宽线在多少计数上】:
 *      起步点【不在】线上(当前实测): 线在 850K = 一圈的 61%
 *          -> ARM_COUNT = 700000 (= 一圈的 50%): 比线早 10%(≈0.6 m)解除封印,
 *             车跑到线上就停。取 50% 是"留足余量、又绝不在半路误判"的折中。
 *      起步点【正好在】线上(H 题要求的做法): 线出现在 ~1400K = 100%
 *          -> ARM_COUNT = 1120000 (= 一圈的 80%)。
 *      ⚠ 一句话记法: **ARM_COUNT = 线所在的计数 − 一圈的 10%~20%**。
 *        换了起步位置就必须跟着改这一个数, **不要照抄 80%**。
 * ============================================================ */
#define STOP_LINE_ENABLE      1    /* ★ 1 = 启用自动停车(2026-09-29 20:30 打开)
                                    *   0 = 只记录不停车(标定用的观测模式) */
#define STOP_LINE_MIN_ACTIVE  4    /* 连续几路【同时】压黑才算(2~5)
                                    *   ⚠ 3 会误判: 弯道里斜着压普通线就能凑出来 */
#define STOP_LINE_CONFIRM     6    /* 连续几拍都成立才判定(6 拍 = 30 ms) */
#define STOP_LINE_ARM_TICKS   200  /* 启动后多少拍内不检测(防启停线误判) */
#define STOP_LINE_ARM_COUNT   1120000 /* ★★ 里程门槛: 已走的编码器平均计数 >= 这个数
                                    *   才允许【压线停车】。0 = 不生效(⚠ 还会误判!)
                                    * ★ 1120000 = 一圈(1400000)的 80%。
                                    *   前提: 那条 5 cm 线【在起步点上】(H 题的做法),
                                    *   这样它会被压在 ~1400K(100%)处 > 1120K ✅
                                    * ⚠⚠ 如果线【不在】起步点(比如还在前方 850K 处),
                                    *   1120K 比它靠后 → 压线这个入口会【完全不动作】,
                                    *   车改由下面的"里程停车"停在起步点 —— 这是有意的,
                                    *   不是坏了。想让压线也生效: 把线挪到起步点(推荐),
                                    *   或把本值改到"线所在计数 − 一圈的 10%"。
                                    * 一句话: ARM_COUNT = 线所在的计数 − 一圈的 10~20%。 */

/* ============================================================
 *          里 程 停 车 (safe/track.c) —— 2026-09-29 晚新增
 * ============================================================
 * 需求原话(用户): "我想实现从起步点出发, 在起步点停止"。
 *
 * ★★ 为什么【必须】单独立一个判据 —— 压线停车做不到这件事:
 *   压线只能把车停在【那条线的物理位置】。实测那条 5 cm 线在起步点
 *   前方 850K(= 一圈的 61%)处 —— 靠压线停, 车会在跑完 61% 圈时就停下,
 *   根本回不到起步点。要停在【起步点】, 唯一能用的参照物就是【里程】。
 *
 * ★ 和压线停车的关系: 两个入口【同时开着、互不干扰、还能互相印证】。
 *   · 线正好在起步点(H 题标准做法): 两个判据几乎在同一瞬间成立 →
 *     谁先成立谁停, 结果一样; 而"压线"那一侧提供了物理位置这个高精度参照。
 *   · 线不在起步点(现在的布局): 压线那一侧被里程门槛挡住(不误停),
 *     由里程把车准时停在起步点。
 *
 * ★ 精度: 里程 = 编码器平均计数, 与真实距离成正比。标定过"一圈"之后,
 *   重复性误差量级是百分之几(≈几厘米)。要冲 H 题的"停车偏差 <=2cm",
 *   最稳的还是把那条线挪到起步点、让两个判据一起成立。
 * ⚠ 因为它是纯里程判据(不看传感器), 中途有没有丢线、有没有别的黑斑都不影响
 *   —— 顺带也是一道"跑完就停"的保险。
 * ============================================================ */
#define STOP_MILEAGE_ENABLE   1     /* 1 = 打开里程停车; 0 = 关闭(只用压线停) */
#define STOP_MILEAGE_COUNT    1400000 /* ★ 停车里程(编码器平均计数)。
                                     *   默认 = 一圈(MILEAGE_LAP_COUNT)。
                                     *   ★ 想让车【停得早一点】→ 调小; 晚一点 → 调大。
                                     *   ★ 想跑 N 圈再停 → 填 N × 一圈计数
                                     *     (例: 两圈 = 2800000)。一次启动就停一次,
                                     *     想连着练多圈就把 STOP_MILEAGE_ENABLE 改 0。
                                     *   标尺: 一圈 1400000 计数 = 6.142 m
                                     *          → 1 cm ≈ 2300 计数。
                                     *   ⚠ 只影响"停车位置", 不影响 B 点提示
                                     *     (B 点用的是 MILEAGE_LAP_COUNT, 两者独立)。 */

/* ============================================================
 *           里 程 / A·B 点 (safe/mileage.c)
 * 2026-09-29 新增。
 *
 * 为什么需要: 2026 电赛 H 题《车载平衡滚球运动控制系统》要求
 *   · 第 2 项: 从 A 点出发顺时针跑一圈, <=20 s, 停车偏差 <=2 cm
 *   · 第 3/4 项: 通过 B 点时要有【声光提示】
 * 而本工程【没有串口、没有陀螺仪】, 唯一能给"我在赛道的哪一段"提供
 * 依据的就是【编码器里程】。
 *
 * 赛道(题面): A->B 直线 1.5 m, B->C 半圆 R0.5 m,
 *              C->D 直线 1.5 m, D->A 半圆 R0.5 m
 *   一圈 = 2 x 1.5 + 2 x (pi x 0.5) = 6.142 m
 *   A 点处有一条 5 cm 长、与环路垂直的【启停线】。
 *
 * ★★ 关键设计: A/B 两点在赛道上的【比例】是固定的, 与轮径、编码器
 *    分辨率都无关:
 *        B 点 = 1.5 / 6.142 = 24.4% 圈
 *        A 点 = 1 圈 (100%)
 *    所以【只要标定"一圈有多少编码器计数"这一个数】, A/B 两点就都出来了。
 *
 * ★ 里程怎么算: (|左轮计数| + |右轮计数|) / 2。
 *   取绝对值是为了不怕某一侧编码器接线反相; 取两轮平均是因为绕圈时
 *   内外轮走的路本来就不一样, 平均才代表【车体中心】走了多远
 *   (而"到没到 A 点"问的正是车体中心)。
 *   计数从"按下启动"那一刻开始(启动时 main.c 会 Encoder_Reset())。
 *
 * ⚠ 未标定(本值为 0)时: A/B 点提示【不动作】, 里程门槛也不生效 ——
 *   这是有意的, 免得拿一个假数去判停车。
 * ============================================================ */
#define MILEAGE_LAP_COUNT   1400000 /* ★ 跑完一圈的编码器平均计数。0 = 未标定。
                                    * ★★ 2026-09-29 标定完成 —— 三次独立读数
                                    *   (屏上显示的单位已是 1000 计数):
                                    *     1580 / 1202  -> 1391 K      (T 32.7 s)
                                    *     1606 / 1224  -> 1415 K      (T 27.1 s)
                                    *     1582 / 1204  -> 1393 K      (T 25.5 s)
                                    *   三次平均 1 399 599, 互相只差 1.7% -> 取
                                    *   1 400 000 (相对误差 <0.1%)。
                                    *   标定方法: STOP_LINE_ENABLE 保持 0, 跑一圈,
                                    *   读屏上 ENC 那一行的两个数(各乘 1000 再取平均)。
                                    * ⚠ 换轮子/编码器/减速比之后必须重标。 */
#define MILEAGE_B_RATIO_PM  244    /* B 点位置占一圈的千分比 = 1500/6142。
                                    * ★ 不用改: 赛道尺寸是题面定死的。 */
/* ★ 里程门槛(STOP_LINE_ARM_COUNT)怎么填: 取一圈计数(MILEAGE_LAP_COUNT)的
 *   80% 左右 —— 也就是一圈的最后 20%(约 1.2 m)才允许触发停车。
 *   例: 一圈 12000 → STOP_LINE_ARM_COUNT 填 9600。 */

/* ============================================================
 *           声 光 提 示 (safe/signal.c) —— 蜂鸣器 + LED
 * 2026-09-29 新增。H 题要求"通过 B 点时声光提示"。
 *      声 = 蜂鸣器(PB0)      光 = PC13 板载 LED
 *
 * ★ 蜂鸣器是【有源模块】(给电就自带振荡发声, 所以 IO 直接通断即可, 不需要 PWM)。
 *   ★★ 电平方向: 实测确认 = 【高电平响】(BUZZER_ACTIVE_LEVEL = 1)。
 *      2026-09-29 晚用户实测反馈"蜂鸣器没问题、正确" —— 上电安静、提示音正常。
 *   ⚠ 早先这里的注释写的是"低电平触发", 与宏值(1)矛盾, 已按实测改掉。
 *     这类方向只能实测(本项目在传感器极性上已栽过两次), 结论定下来就别再改。
 *   (无源蜂鸣器才需要方波, 那时要改用 TIM3_CH3 出 PWM。)
 * ⚠ PB0 = TIM3_CH3。本工程 TIM3 只用 CH1/CH2(PB4/PB5) 做电机 PWM,
 *   CH3 空闲 —— 所以 PB0 才能当普通 GPIO 用。将来动 TIM3 时注意别碰 CH3。
 * ⚠ PC13 是 RTC_TAMPER 引脚, 输出能力弱(<=3 mA), 板载 LED 已串了较大
 *   限流电阻, 只适合点灯, 不要再往上挂别的负载。
 * ============================================================ */
#define BUZZER_ACTIVE_LEVEL  1     /* 0 = 低电平响; 1 = 高电平响。
                                    * ★ 本车实测 = 1(2026-09-29 晚用户确认)。别改。 */
#define LED_ACTIVE_LEVEL     0     /* 0 = 低电平亮(蓝药丸 PC13 的接法); 1 = 高电平亮 */
#define SIGNAL_BEEP_MS       60    /* 短提示音时长(ms) */
#define SIGNAL_LONG_MS       400   /* 长提示音时长(ms) */
#define SIGNAL_GAP_MS        120   /* 连响之间的间隔(ms) */

/* ============================================================
 *                 跑 圈 计 时 (safe/stopwatch.c)
 * 2026-09-29 新增。用来对着 H 题"一圈 <= 20 s"的要求掐表。
 *
 * ★ 不占用任何按键手势: 计时【自动跟随循迹开关】——
 *     短按启动 -> 计时归零, 开始跑;
 *     短按停止 -> 冻结, 那个数就是这一圈的成绩(自动成为"上一圈");
 *     双击/三击切极性会强制停车, 计时也跟着停(不会留下一条假成绩)。
 *
 * 显示在第 1 行右侧(6x10 字体, 字符宽 6 px):
 *     运行中: "RUN T12.3 L11.8"   T = 本次(递增)  L = 上一圈
 *     停止时: "STOP PL1 TS-1 T12.3"  顺带把两个极性标定值亮出来
 *   ★ 一个数字位不够看对比 —— 跑第二圈时能直接看到上一圈多少, 所以放两个。
 * ============================================================ */
#define STOPWATCH_MAX_MS    599999u  /* 计时上限(ms), 约 10 分钟。到顶就停在
                                      * 那里, 免得长时间不动把数字撑出屏外。 */

/* ============================================================
 *                      全 局 控 制 节 拍
 * 单位 ms。这一个值决定 SysTick(1ms) 的分频数, 改一处即可。
 * 越小 -> 采样越快, 对传感器/地面反射滞后的容忍度越好, 但中断更频繁。
 * ============================================================ */
#define CTRL_PERIOD_MS      5u

#endif
