xiesiqi1/git-test/Core/Inc/main.h

#define IN3_Pin GPIO_PIN_9
#define IN3_GPIO_Port GPIOA
#define IN1_Pin GPIO_PIN_11
#define IN1_GPIO_Port GPIOA
#define IN2_Pin GPIO_PIN_12
#define IN2_GPIO_Port GPIOA
#define KEY_Pin GPIO_PIN_15
#define KEY_GPIO_Port GPIOA
#define IN4_Pin GPIO_PIN_3
#define IN4_GPIO_Port GPIOB
#define OLED_RES_Pin GPIO_PIN_8
#define OLED_RES_GPIO_Port GPIOA
#define OLED_CS_Pin GPIO_PIN_12
#define OLED_CS_GPIO_Port GPIOB
#define OLED_DC_Pin GPIO_PIN_14
#define OLED_DC_GPIO_Port GPIOB
#define BUZZER_Pin GPIO_PIN_0
#define BUZZER_GPIO_Port GPIOB
#define LED_Pin GPIO_PIN_13
#define LED_GPIO_Port GPIOC
