xiesiqi1/git-test/safe/oled.h

#ifndef __OLED_H
#define __OLED_H

#include "main.h"

/* ============================================================================
 *  OLED 显示模块 (1.3 寸 SH1106 128x64, 软件 SPI / 硬件 SPI2)
 *  2026-09-28 新增。
 *
 *  为什么要它:
 *      本工程【没有任何串口】(PA9/PA2/PA3 都被电机/探头占用了),
 *      想看一眼"居中的误差是多少、差速下发了多少、编码器走到哪了"
 *      以前是完全没办法 —— 只能靠上车跑圈看现象反推。
 *      有了这块屏, 调参从"猜"变成"看"。
 *
 *  接线 / 引脚 / CubeMX 配置见 car.txt 的【OLED 章节】。
 *
 *  用法(main 的 while(1) 里):
 *      Oled_Init();          // 上电调一次
 *      while(1) { ...; Oled_Task(); }   // 主循环里反复调, 内部自己限速
 * ========================================================================== */

/* 上电初始化(含 SH1106 的复位时序 + 显示一帧自检信息)。 */
void Oled_Init(void);

/* 主循环里反复调用即可。内部按 SIMPLE_OLED_REFRESH_MS 限速,
 * 不会每次都真的刷屏 —— 刷一屏要阻塞约 1.8 ms(4.5 MHz 下 1024 字节)。 */
void Oled_Task(void);

/* 立刻刷一屏(不管限速)。 */
void Oled_Refresh(void);

#endif
