xiesiqi1/git-test/(commit log)

2026-09-07 上传STM32初始化工程
2026-11-01 chore: 添加 .gitignore，停止跟踪 Keil 编译产物与本地配置
    - 125 个文件移出索引（仅停止跟踪，本地文件保留）：
    MDK-ARM/Test1/ 输出目录(.o/.d/.crf/.axf/.hex/.map/.dep/.lnp/.sct/.htm)、
    TEST1.uvguix.siqi(个人窗口布局)、EventRecorderStub.scvd、
    MDK-ARM/.vscode 日志、.vscode/、.mxproject
    - 保留 *.uvprojx / *.uvoptx 工程配置（用 ! 反选）
2026-11-01 feat: 五路循迹控制、OLED 调试界面与双入口自动停车
    【循迹控制】
    - 五路红外夹线定位(-4~+4, 99=丢线)，开环 PWM + 比例 + 虚拟前视(LEAD_TICKS=30)
    - 弯道按差速成比例收油，并以 CORNER_SLOW_MAX=6 封顶，避免曲率积分把 base 压到地板
    - 差速 slew 限幅；丢线分级处理(LOST_SPEED 降速 + 搜索补力)
    - 传感器极性/转向极性可在按键上标定并存 Flash，不重新编译也能改
    【里程与停车】
    - 重写 encoder.c：新增 Encoder_Update() 每拍累加，修复 total 恒 0 导致里程失效
    - mileage.c：一圈标定 1400000 计数，A/B 点按 244‰ 比例提示
    - track.c：压停止线(连续 4 路 + 6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
    [TEST1.ioc, config.h, encoder.c, encoder.h, key.c, key.h, main.c]
2026-11-01 docs: README 补充克隆步骤与编译产物说明
